QUT-Motorsport/QUTMS_TSAL/hardware/TSAL LED/Project Outputs for LED STRING/LED STRING.xlsx

Comment | Description | Designator | Footprint | LibRef | Quantity
XPERED-L1-R250-00401 | LED, Cree XLamp XP-E2 Series, Red, 630 nm, 130 °, 62 lm, 1 A | DS1, DS2, DS3, DS4 | Cree XLamp XP-E2 (red and green LED) | XPEBRD-L1-0000-00601 | 4
XPEGRN-L1-0000-00B01 | LED, Cree XLamp XP-E2 Series, Green, 535 nm, 135 °, 87.4 lm, 1 A | DS5, DS6, DS7 | Cree XLamp XP-E2 (red and green LED) | XPEBGR-L1-0000-00A01 | 3
Header 4 | Header, 4-Pin | P1, P2 | HDR1X4 | Header 4 | 2
