QUT-Motorsport/QUTMS_TSAL/hardware/TSAL LED/Project Outputs for TSAL2/TSAL2.xlsx

Comment | Description | Designator | Footprint | LibRef | Quantity
10uF 50V 5% X7R 0603 | Capacitor, Ceramic, SMD, 10uF, 50V, 5%, X7R, 0603 | C2_GREEN LED DRIVER, C2_RED LED DRIVER | Cap_Ceramic_0603(10uf) | 10uF 50V 5% X7R 0603 | 2
CMD21L8 TRPBFREE |  | D1_Voltage Reducer1, D1_Voltage Reducer2 | SODFL160X80-2N(Zener) | CMD21L8 TRPBFREE | 2
PMEG2005EJ | Diode, Schottky, SMD, 20 V, 500 mA, Single, SOD-323F, 2 Pins, 390 mV | D2_GREEN LED DRIVER, D2_RED LED DRIVER | SOD-323F(shottkey) | PMEG2005EJ | 2
SRN6045-101M | Inductor, 100 µH, 700 mA, Semishielded, 800 mA, SRN6045 Series, 6mm x 6mm x 4.5mm | L1_GREEN LED DRIVER, L1_RED LED DRIVER | Bourns Inductor 6x6x4.5mm(100mH) | SRN6045-101M | 2
LBL Hot Surface S | LBL Hot Surface S | LOGO1, LOGO3 | LBL HOT SMALL | LBL Hot Surface S | 2
2 Layer Identification PCB Marker | 2 Layer Identification PCB Marker | LYID1 | LAYER IDENT 2 | Layer Identification 2 | 1
Header 4 | Header, 4-Pin | P? | HDR1X4 | Header 4 | 1
10k 5% 0603 | Resistor, SMD, 10k, 0.1W, 5%, 0603 | R1_Voltage Reducer1, R1_Voltage Reducer2, R3_GREEN LED DRIVER, R3_RED LED DRIVER | Res_ThinFilm_0603 (1,10k) | 10k 5% 0603 | 4
1 1% 0603 | Resistor, SMD, 1, 0.1W, 1%, 0603 | R2_GREEN LED DRIVER, R2_RED LED DRIVER | Res_ThinFilm_0603 (1,10k) | 1 1% 0603 | 2
AP8801 | the LED drver fotr the red and green LED's | U1_GREEN LED DRIVER, U1_RED LED DRIVER | SOP8/SO8(AP8801) | AP8801 | 2
