QUT-Motorsport/QUTMS_TSAL/hardware/TSAL Control/Project Outputs for QUTMS-TSAL-V00/QUTMS-TSAL-V00.xlsx

Comment | Description | Designator | Footprint | LibRef | Quantity
4u7 50V | Capacitor, Ceramic, SMD, 4u7, 50V, 5%, X7R, 0603 | C1 | Cap_Ceramic_0603 | 4u7 50V 5% X7R 0603 | 1
10nF 25V 5% X7R 0402 | 10000pF ±5% 25V Ceramic Capacitor X7R 0402 (1005 Metric) | C2 | Cap_Ceramic_1206 | 10nF 25V 5% X7R 0402 | 1
22uF 35V | 22µF ±20% 35V Ceramic Capacitor X5R 1206 (3216 Metric) | C3 | Cap_Ceramic_1206 | 22uF 35V 20% X5R 1206 | 1
100nF 50V | Capacitor, Ceramic, SMD, 100nF, 50V, 5%, X7R, 0603 | C4 | Cap_Ceramic_0603 | 100nF 50V 5% X7R 0603 | 1
MM3Z56VB | Zener Diode 56V 200mW ±2% Surface Mount SOD-323F | D1 | SOD-323F | MM3Z56VB | 1
Microfit 3.0 1x2 |  | J1 | Microfit_1X2_R_TH | Microfit_1x2 | 1
Microfit 3.0 2x3 |  | J2 | Microfit_2X3_R_TH | Microfit_2x3 | 1
20mm Wide QUTMS Logo | 20mm Wide QUTMS Logo | LOGO1 | QUTMS LOGO 20MM | QUTMS Logo 20mm | 1
2 Layer Identification PCB Marker | 2 Layer Identification PCB Marker | LYID1 | LAYER IDENT 2 | Layer Identification 2 | 1
Hole M3 Loose Unplated | M3.5 Hole, No Plating | M1 | M3.5 UNPLATED | Hole M3 Loose Unplated | 1
CPH3351 | P-Channel 60V 1.8A (Ta) 1W (Ta) Surface Mount 3-CPH | Q1, Q2, Q3 | SOT-23-3 | CPH3351 | 3
1k | Resistor, SMD, 1k, 0.1W, 5%, 0603 | R1 | Res_ThinFilm_0603 | 1k 5% 0603 | 1
51k | 51 kOhms ±0.1% 0.063W, 1/16W Chip Resistor 0402 (1005 Metric) Automotive AEC-Q200 Thin Film | R2 | Res_ThinFilm_0603 | 51k 5% 0603 | 1
220R 5% 1206 | 220 Ohms ±1% 0.25W, 1/4W Chip Resistor 1206 (3216 Metric) Moisture Resistant Thick Film | R3 | Res_ThinFilm_1206 | 220R 5% 1206 | 1
1k 5% 0603 | Resistor, SMD, 1k, 0.1W, 5%, 0603 | R4 | Res_ThinFilm_0603 | 1k 5% 0603 | 1
LM555CMX | 555 Type, Timer/Oscillator (Single) IC 100kHz 8-SOIC | U1 | MCP2561 SOIC | LM555CMX | 1
CD4049UB | CD4049UB | U2 | CD4049UB | CD4049UB | 1
FOD817ASD | Optoisolator 5kV Transistor 4SMD | U3 | FOD817ASD | FOD817ASD | 1
