QUT-Motorsport/QUTMS_TSAL/hardware/TSAL LED/Project Outputs for QUTMS-TSAL/QUTMS-TSAL_LED.xlsx

Line # | Name | Description | Designator | Quantity | Manufacturer 1 | Manufacturer Part Number 1 | Manufacturer Lifecycle 1 | Supplier 1 | Supplier Part Number 1 | Supplier Unit Price 1 | Supplier Subtotal 1
 | 10uF X7R | Capacitor, Ceramic, SMD, 10uF, 50V, 5%, X7R, 0603 | C1A, C1B | 2
 | PMEG2005EJ | Diode, Schottky, SMD, 20 V, 500 mA, Single, SOD-323F, 2 Pins, 390 mV | D1A, D1B | 2
 | MMSZ5226BT1G | Diode, Zener, SMD, 3.3 V, 500 mW, SOD-123, 5 %, 2 Pins, 150 °C | D2A, D2B | 2
 | XPEBRD-L1-0000-00601 | LED, Cree XLamp XP-E2 Series, Red, 630 nm, 130 °, 62 lm, 1 A | DS1, DS2, DS3, DS4 | 4
 | XPEBGR-L1-0000-00A01 | LED, Cree XLamp XP-E2 Series, Green, 535 nm, 135 °, 87.4 lm, 1 A | DS5, DS6, DS7 | 3
 | SRN6045-101M | Inductor, 100 µH, 700 mA, Semishielded, 800 mA, SRN6045 Series, 6mm x 6mm x 4.5mm | L1A, L1B | 2
 | LBL Hot Surface S | LBL Hot Surface S | LOGO1, LOGO3 | 2
 | 2 Layer Identification PCB Marker | 2 Layer Identification PCB Marker | LYID1 | 1
 | Header 4 | Header, 4-Pin | P1, P2 | 2
 | 0R27 1% | Resistor, SMD, 0R27, 0.1W, 1%, 0603 | R1A, R1B | 2
 | 10k | Resistor, SMD, 10k, 0.1W, 5%, 0603 | R2A, R2B, R3A, R3B | 4
 | AL8860WT-7 | LED Driver, 1 Output, Buck (Step Down), 4.5 V to 40 V in, 1 MHz switch, PWM, 40V/1 A out, TSOT-25-5 | U1A, U1B | 2
