QUT-Motorsport/QUTMS_TSAL/(threads)

Thread 2 (2020-07-15):

QEV3 TSAL Redesign

LDwhoRU, 2020-07-15:
- [ ] LED Board
- [ ] Control Board
- [ ] Case Design
