QUT-Motorsport/QUTMS_TSAL/hardware/TSAL Control/QUTMS-TSAL-V00.pdf

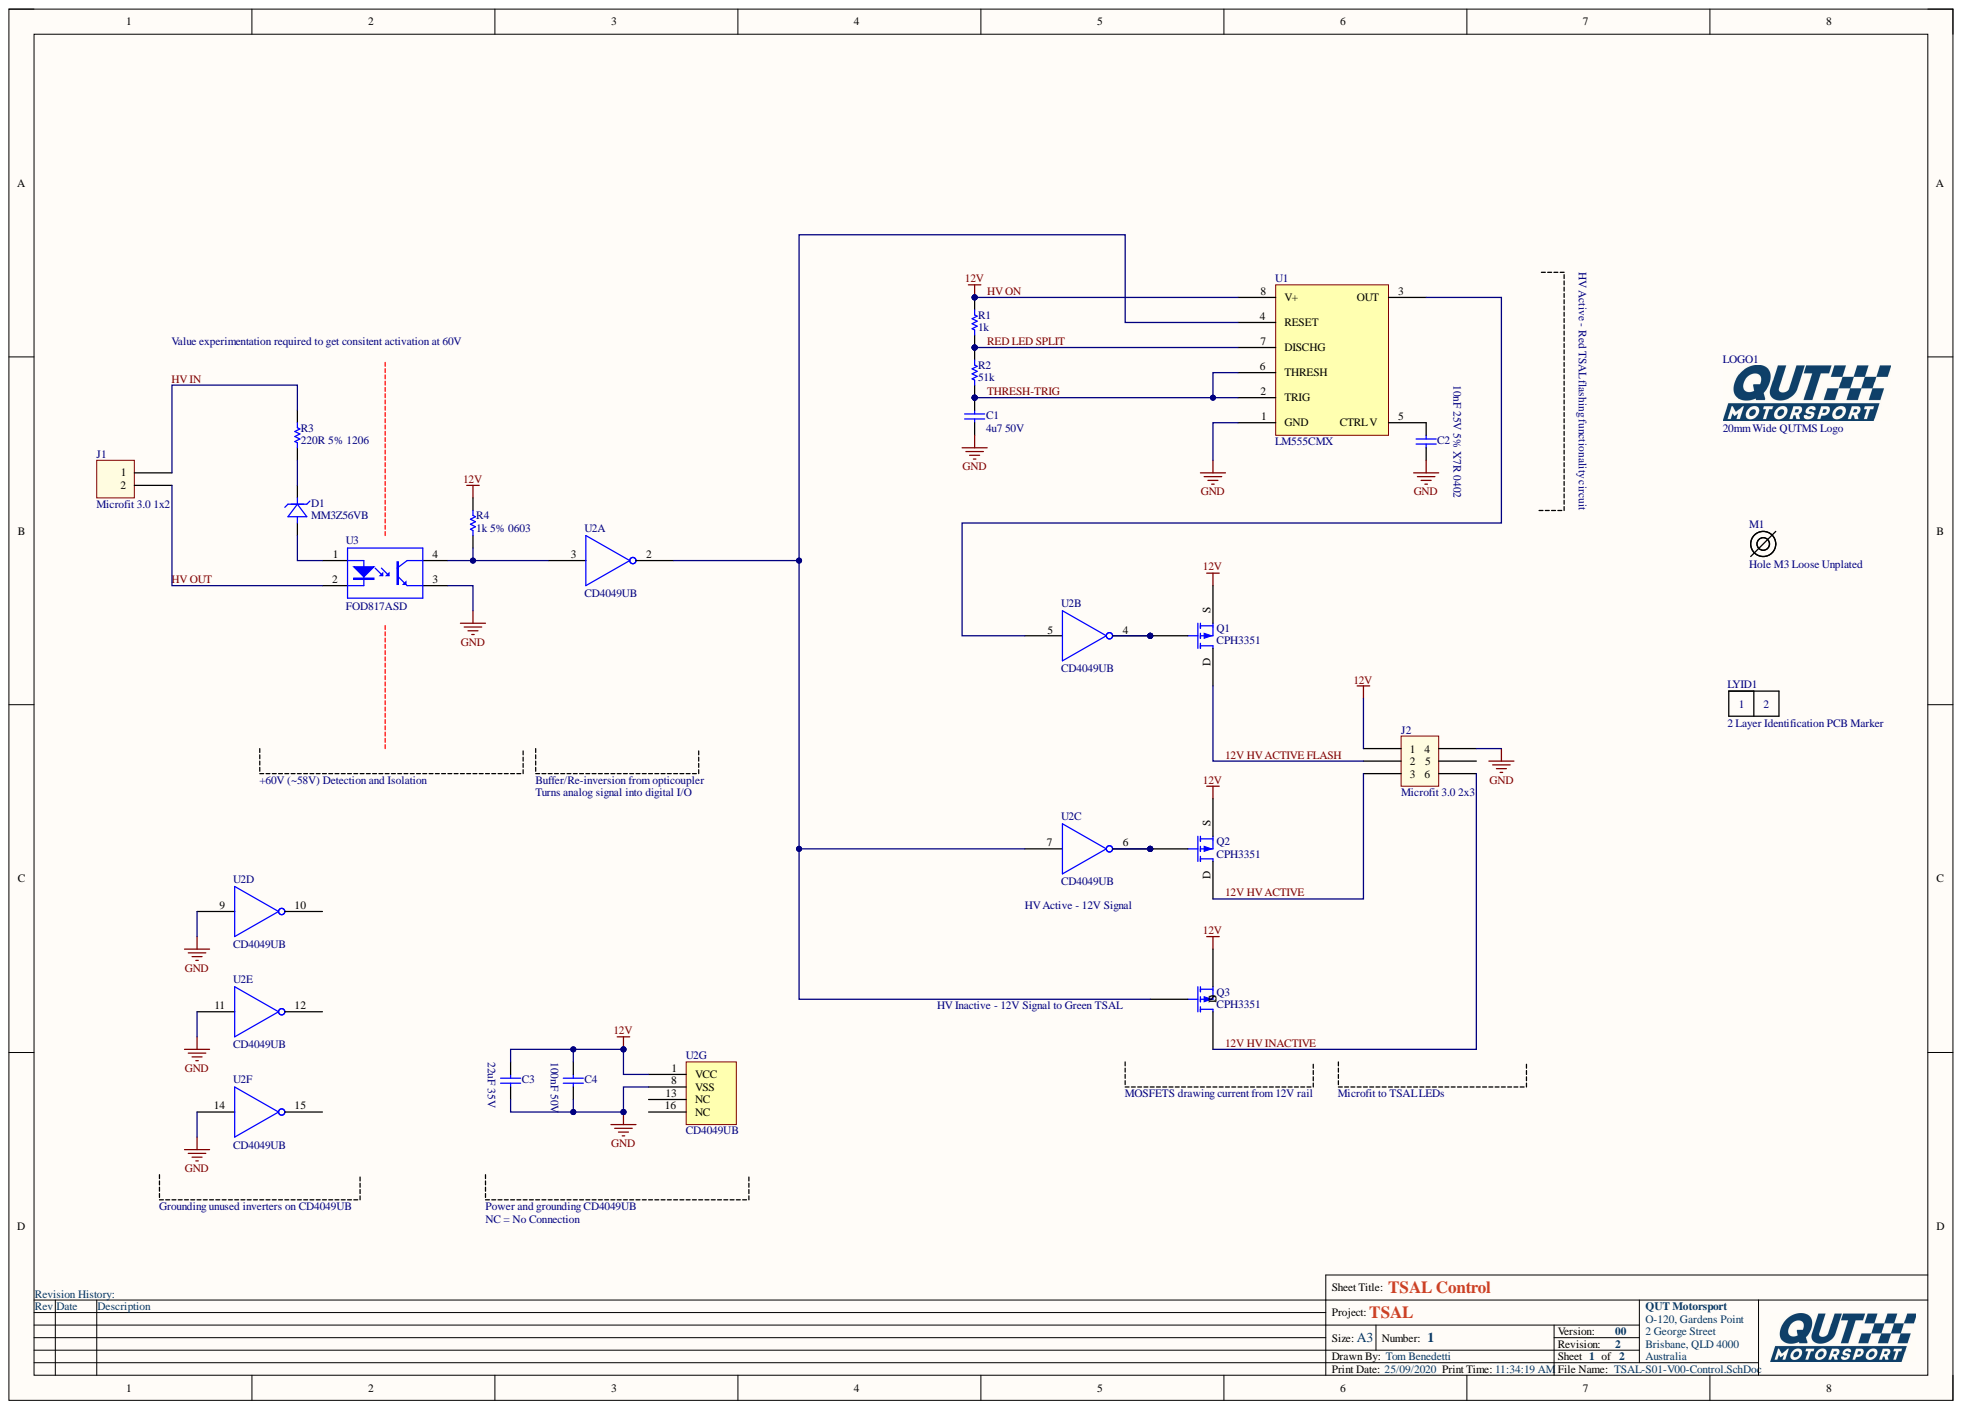
[picture p1: page 1]

HV Active - Red TSALflashing functionality circuit

red to get con

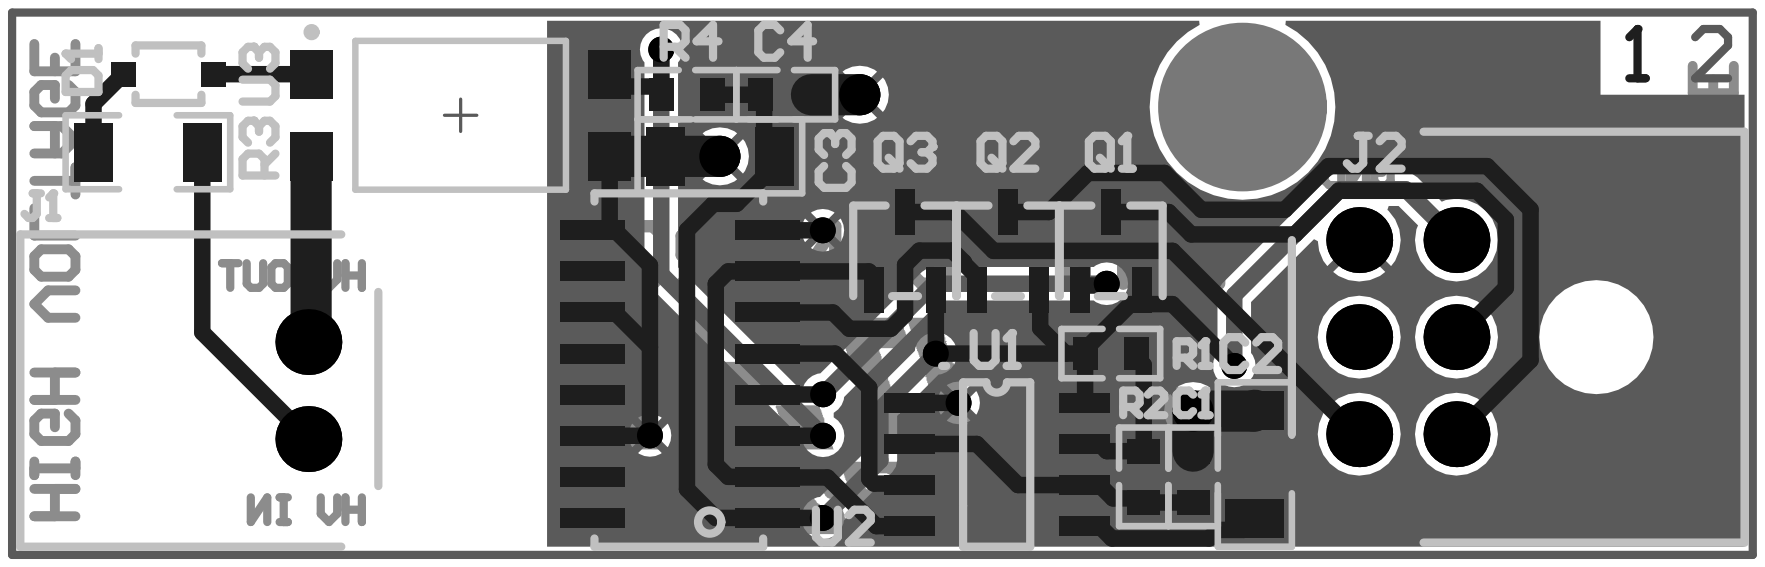
[picture p2: page 2]
