QUT-Motorsport/QUTMS_TSAL/hardware/TSAL LED/QUTMS-TSAL.pdf

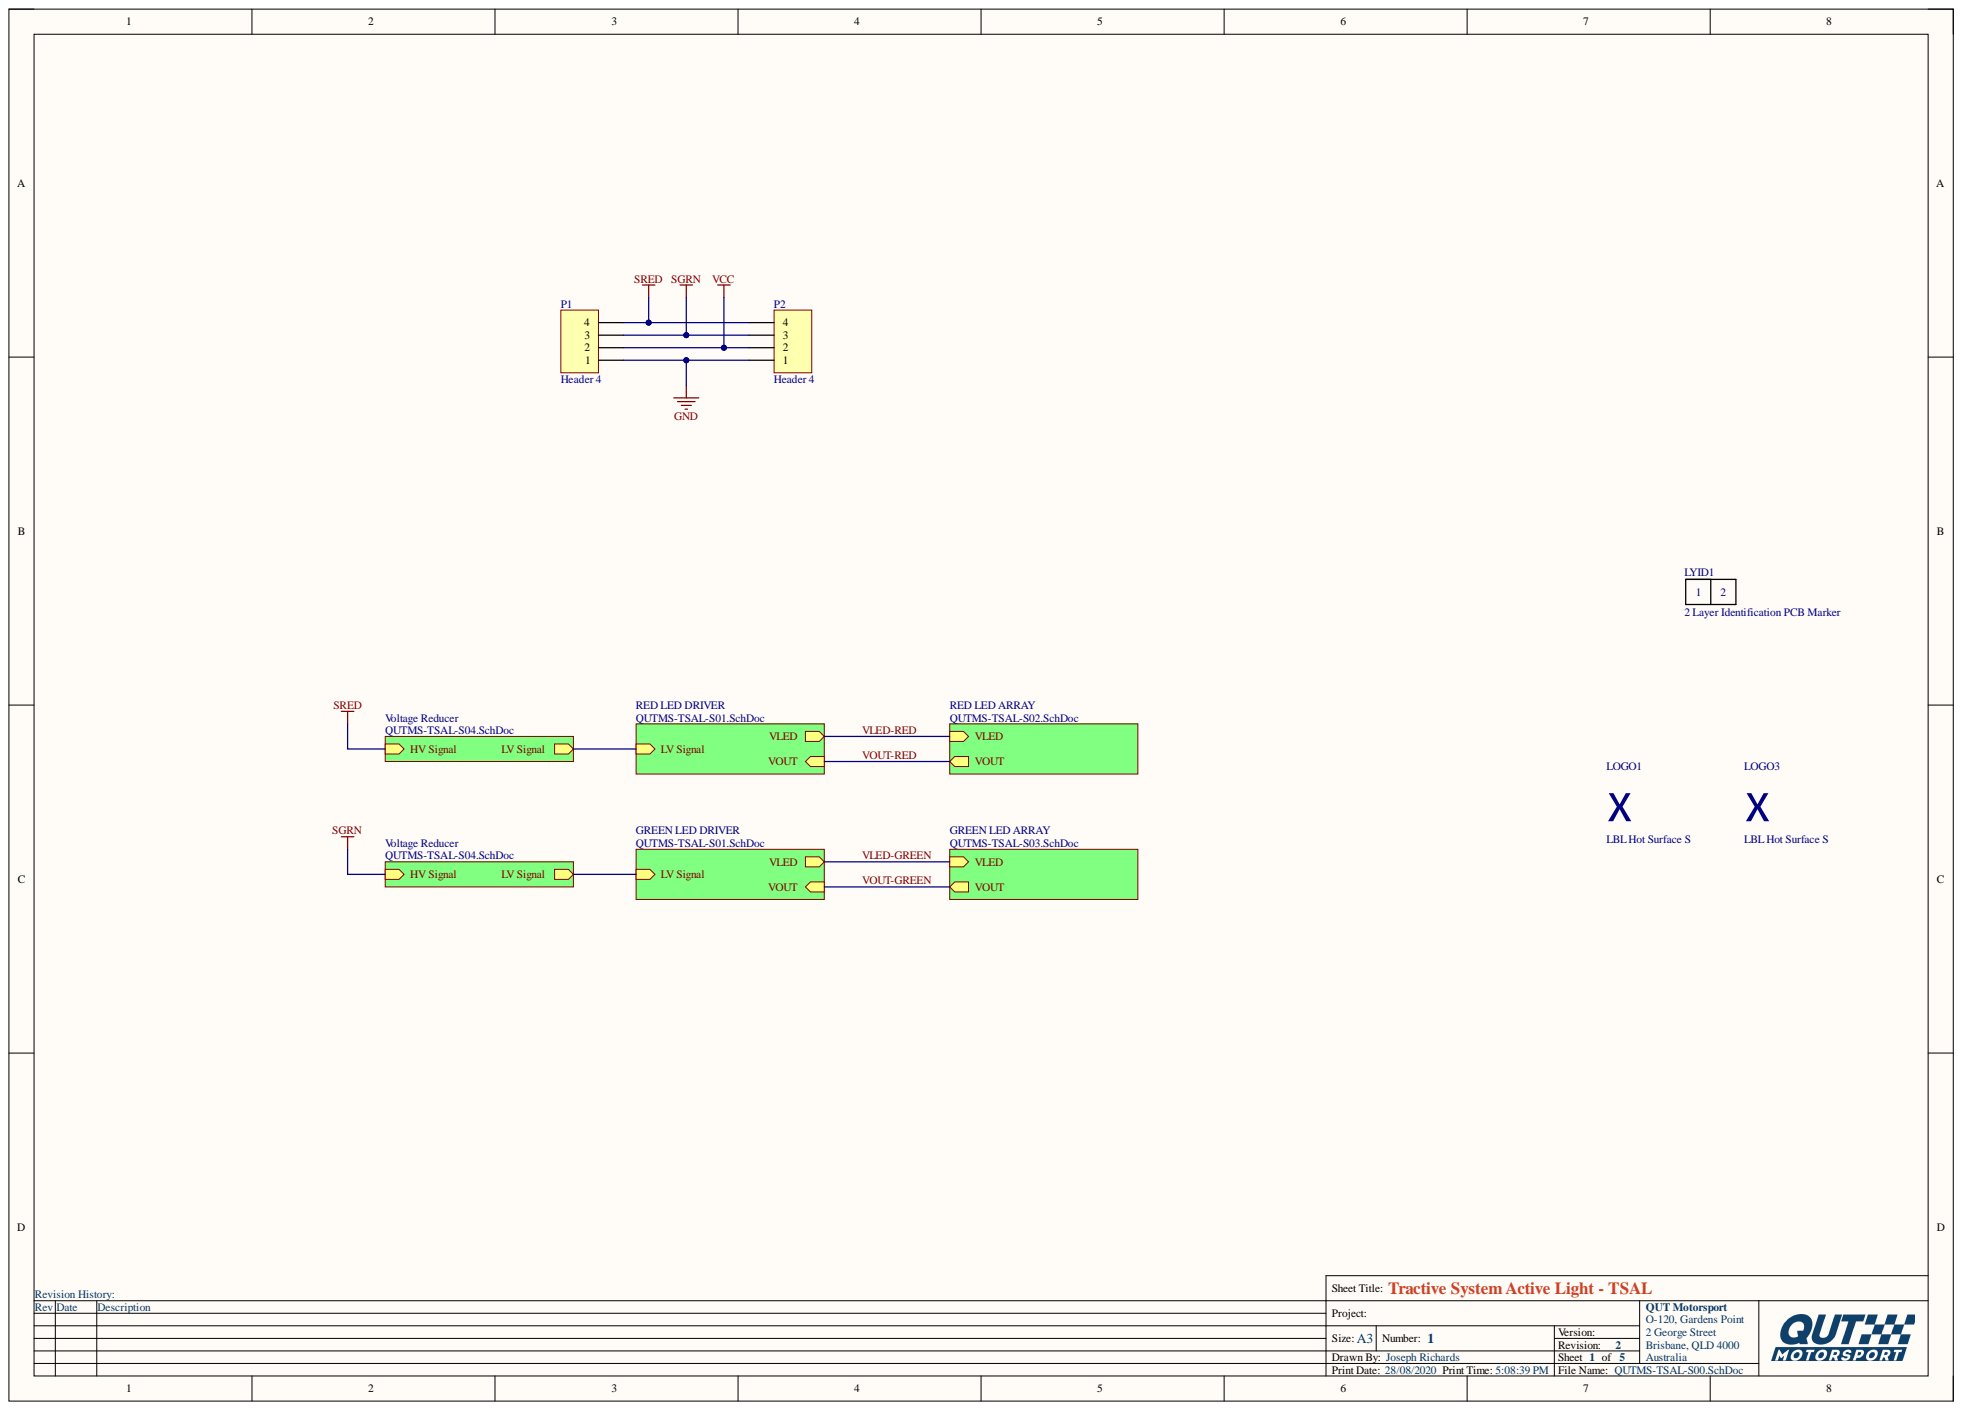
[picture p3: page 1]

LYID1
2 Layer Identification PCB Marker

Sheet Title: Tractive System Active Light - TSAL

Drawn By: Joseph Richards

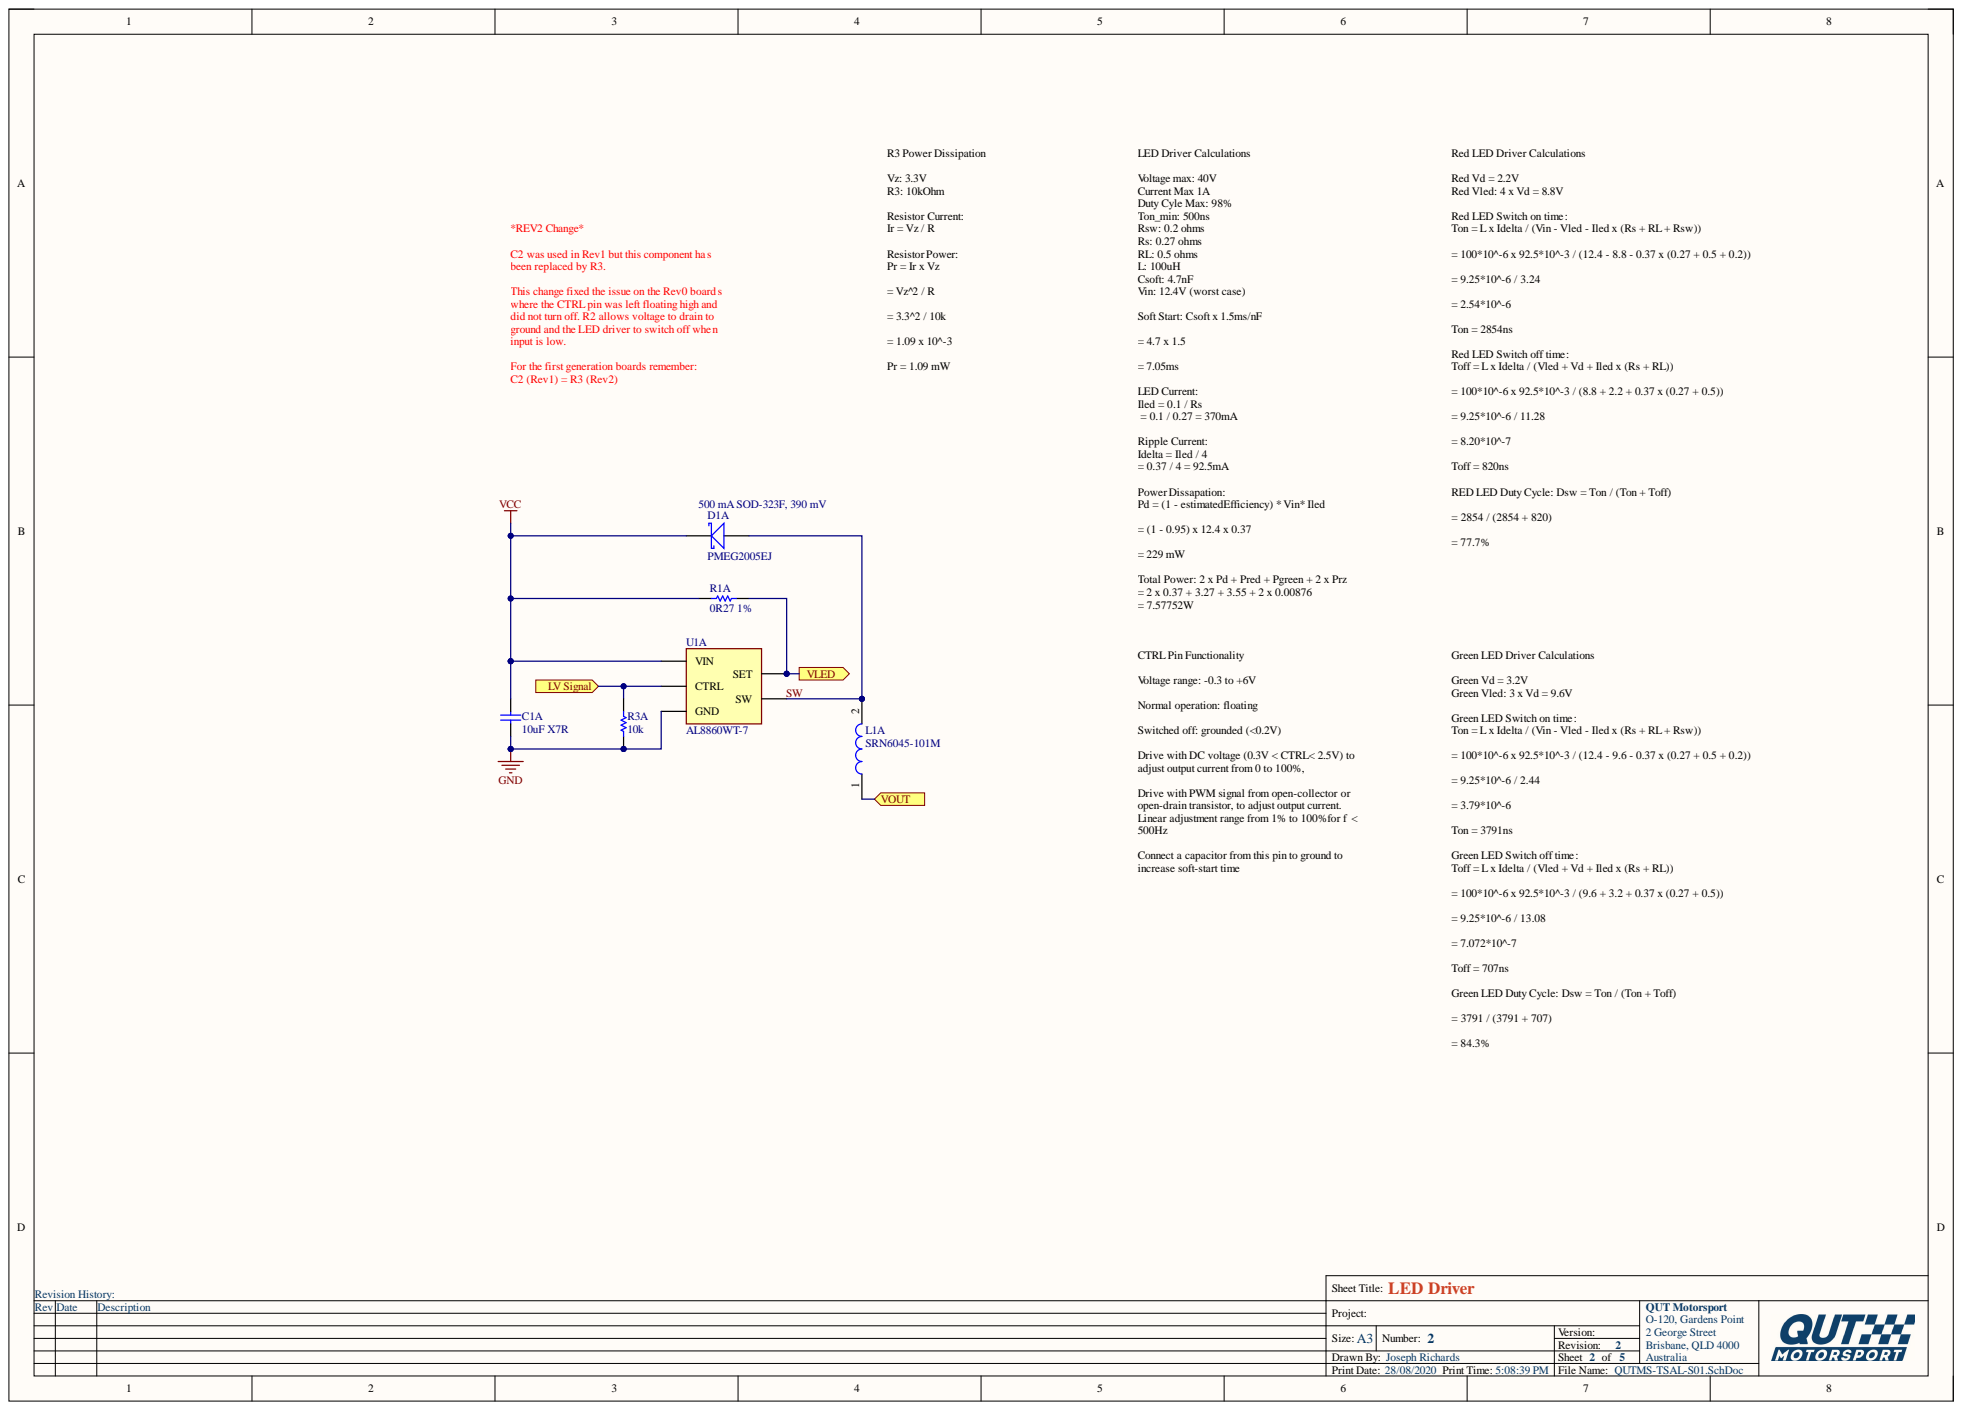
[picture p4: page 2]

Red LED Driver Calculations

Red LED Switch on time:
Ton = L x Idelta / (Vin - Vled - Iled x (Rs + RL + Rsw))

C2 was used in Rev1 but this component has
been replaced by R3.

This change fixed the issue on the Rev0 boards
where the CTRL pin was left floating high and
did not turn off. R2 allows voltage to drain to
ground and the LED driver to switch off when
input is low.

Soft Start: Csoft x 1.5ms/nF

Red LED Switch off time:
Toff = L x Idelta / (Vled + Vd + Iled x (Rs + RL))

For the first generation boards remember:
C2 (Rev1) = R3 (Rev2)

Power Dissapation:
Pd = (1 - estimatedEfficiency) * Vin* Iled

RED LED Duty Cycle: Dsw = Ton / (Ton + Toff)

Total Power: 2 x Pd + Pred + Pgreen + 2 x Prz

Green LED Driver Calculations

Green LED Switch on time:

Drive with DC voltage (0.3V < CTRL< 2.5V) to
adjust output current from 0 to 100%,

Drive with PWM signal from open-collector or
open-drain transistor, to adjust output current.
Linear adjustment range from 1% to 100%for f <

Connect a capacitor from this pin to ground to
increase soft-start time

Green LED Switch off time:

Green LED Duty Cycle: Dsw = Ton / (Ton + Toff)

Sheet Title: LED Driver

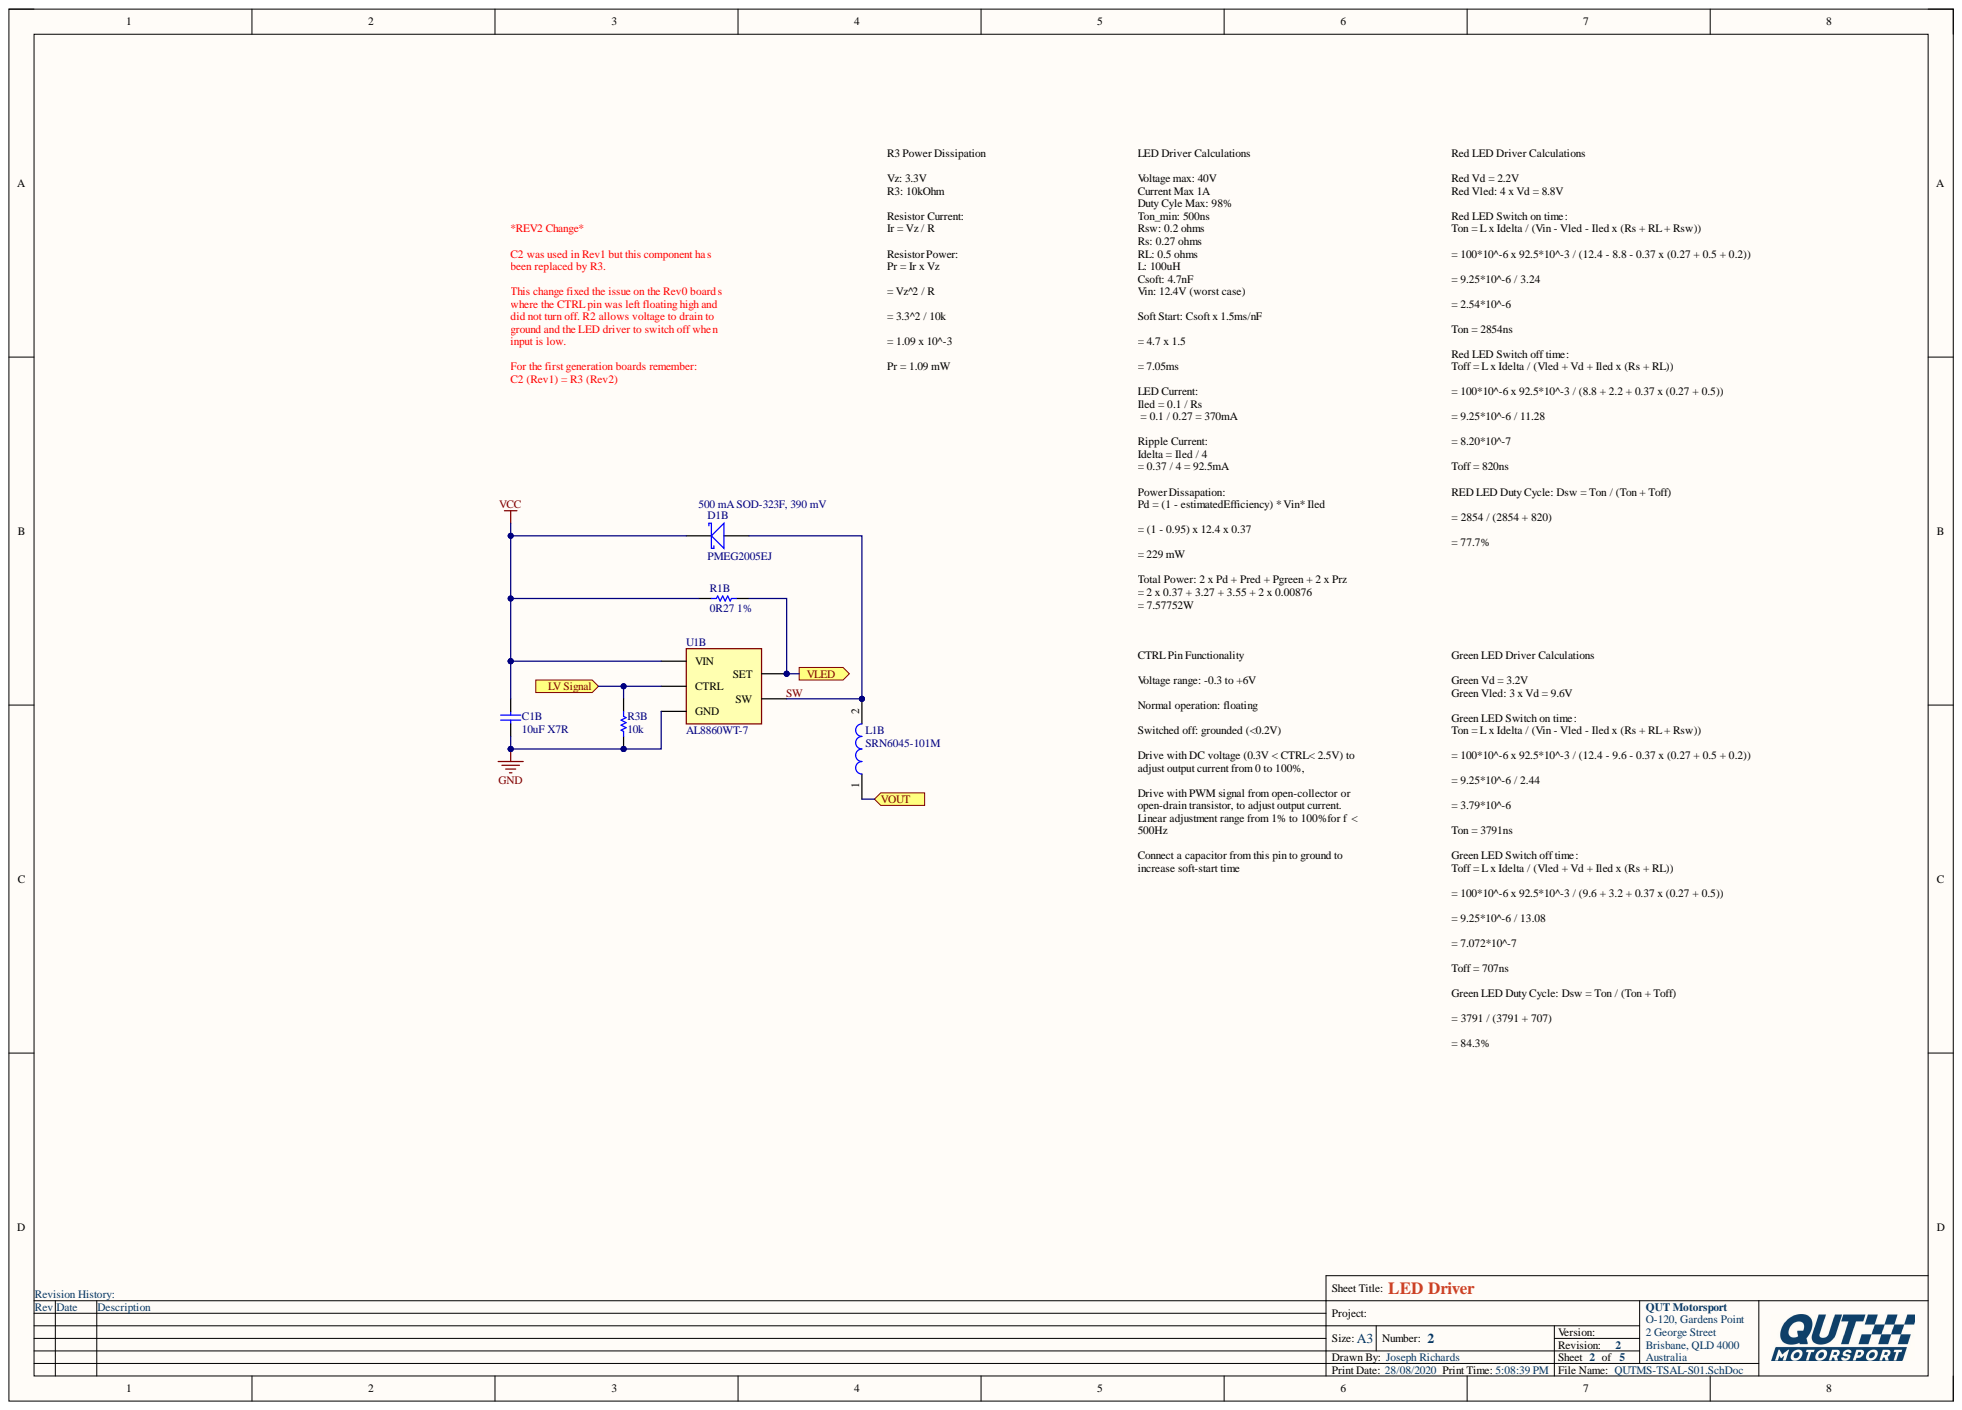
[picture p5: page 3]

Red LED Driver Calculations

Red LED Switch on time:
Ton = L x Idelta / (Vin - Vled - Iled x (Rs + RL + Rsw))

C2 was used in Rev1 but this component has
been replaced by R3.

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

Soft Start: Csoft x 1.5ms/nF

Red LED Switch off time:
Toff = L x Idelta / (Vled + Vd + Iled x (Rs + RL))

For the first generation boards remember:
C2 (Rev1) = R3 (Rev2)

Power Dissapation:
Pd = (1 - estimatedEfficiency) * Vin* Iled

RED LED Duty Cycle: Dsw = Ton / (Ton + Toff)

Total Power: 2 x Pd + Pred + Pgreen + 2 x Prz

Green LED Driver Calculations

Green LED Switch on time:

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

Connect a capacitor from this pin to ground to
increase soft-start time

Green LED Switch off time:

Green LED Duty Cycle: Dsw = Ton / (Ton + Toff)

Sheet Title: LED Driver

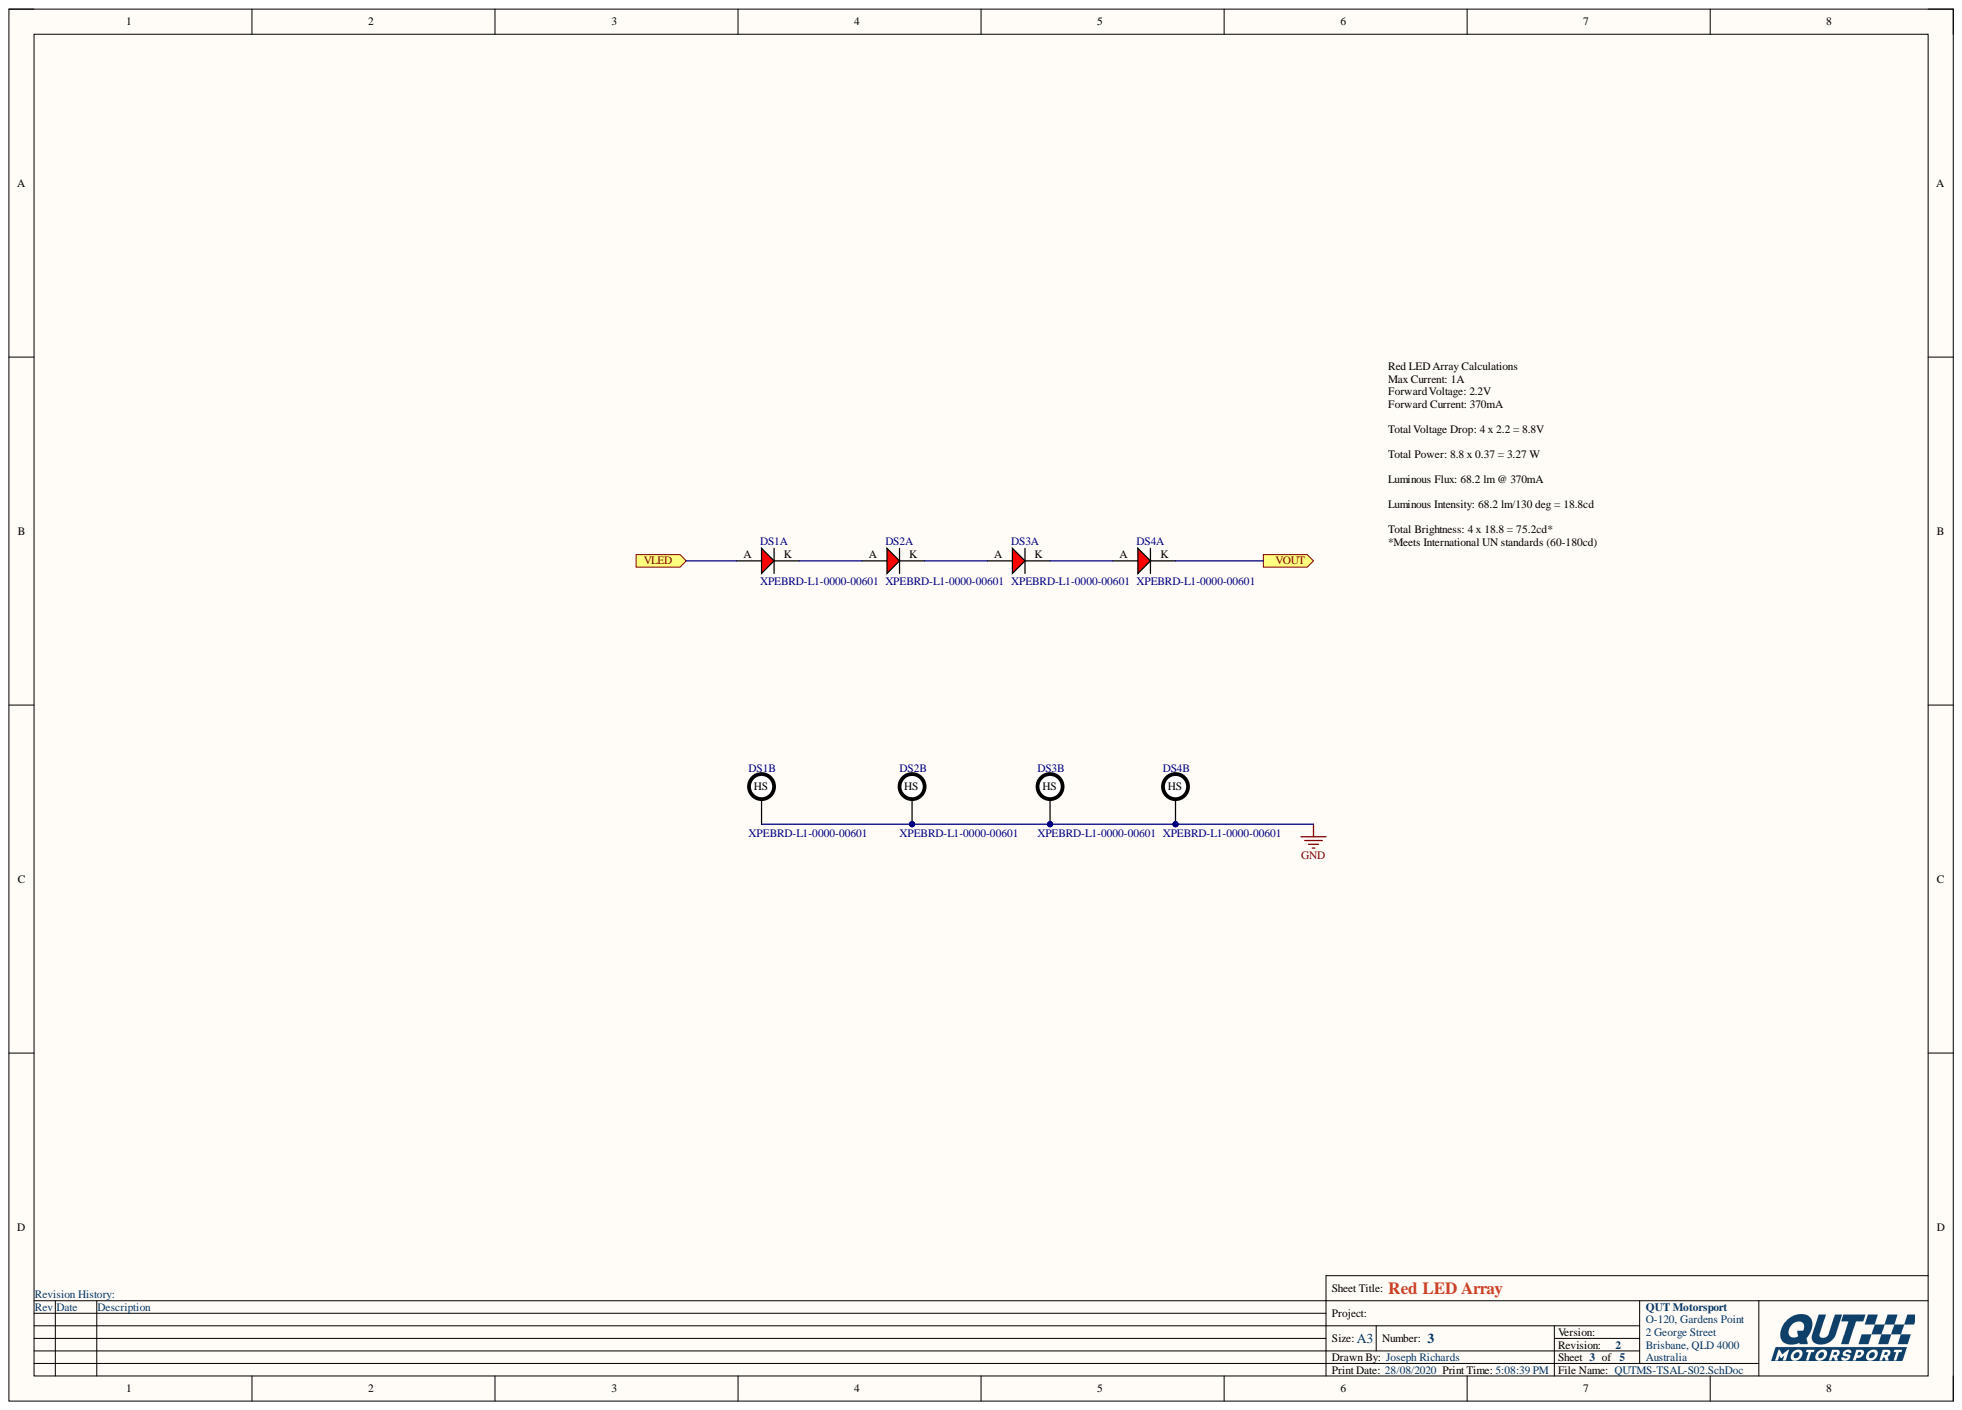
[picture p6: page 4]

Red LED Array Calculations
Max Current: 1A
Forward Voltage: 2.2V
Forward Current: 370mA

Luminous Intensity: 68.2 lm/130 deg = 18.8cd

Total Brightness: 4 x 18.8 = 75.2cd*
*Meets International UN standards (60-180cd)

Sheet Title: Red LED Array

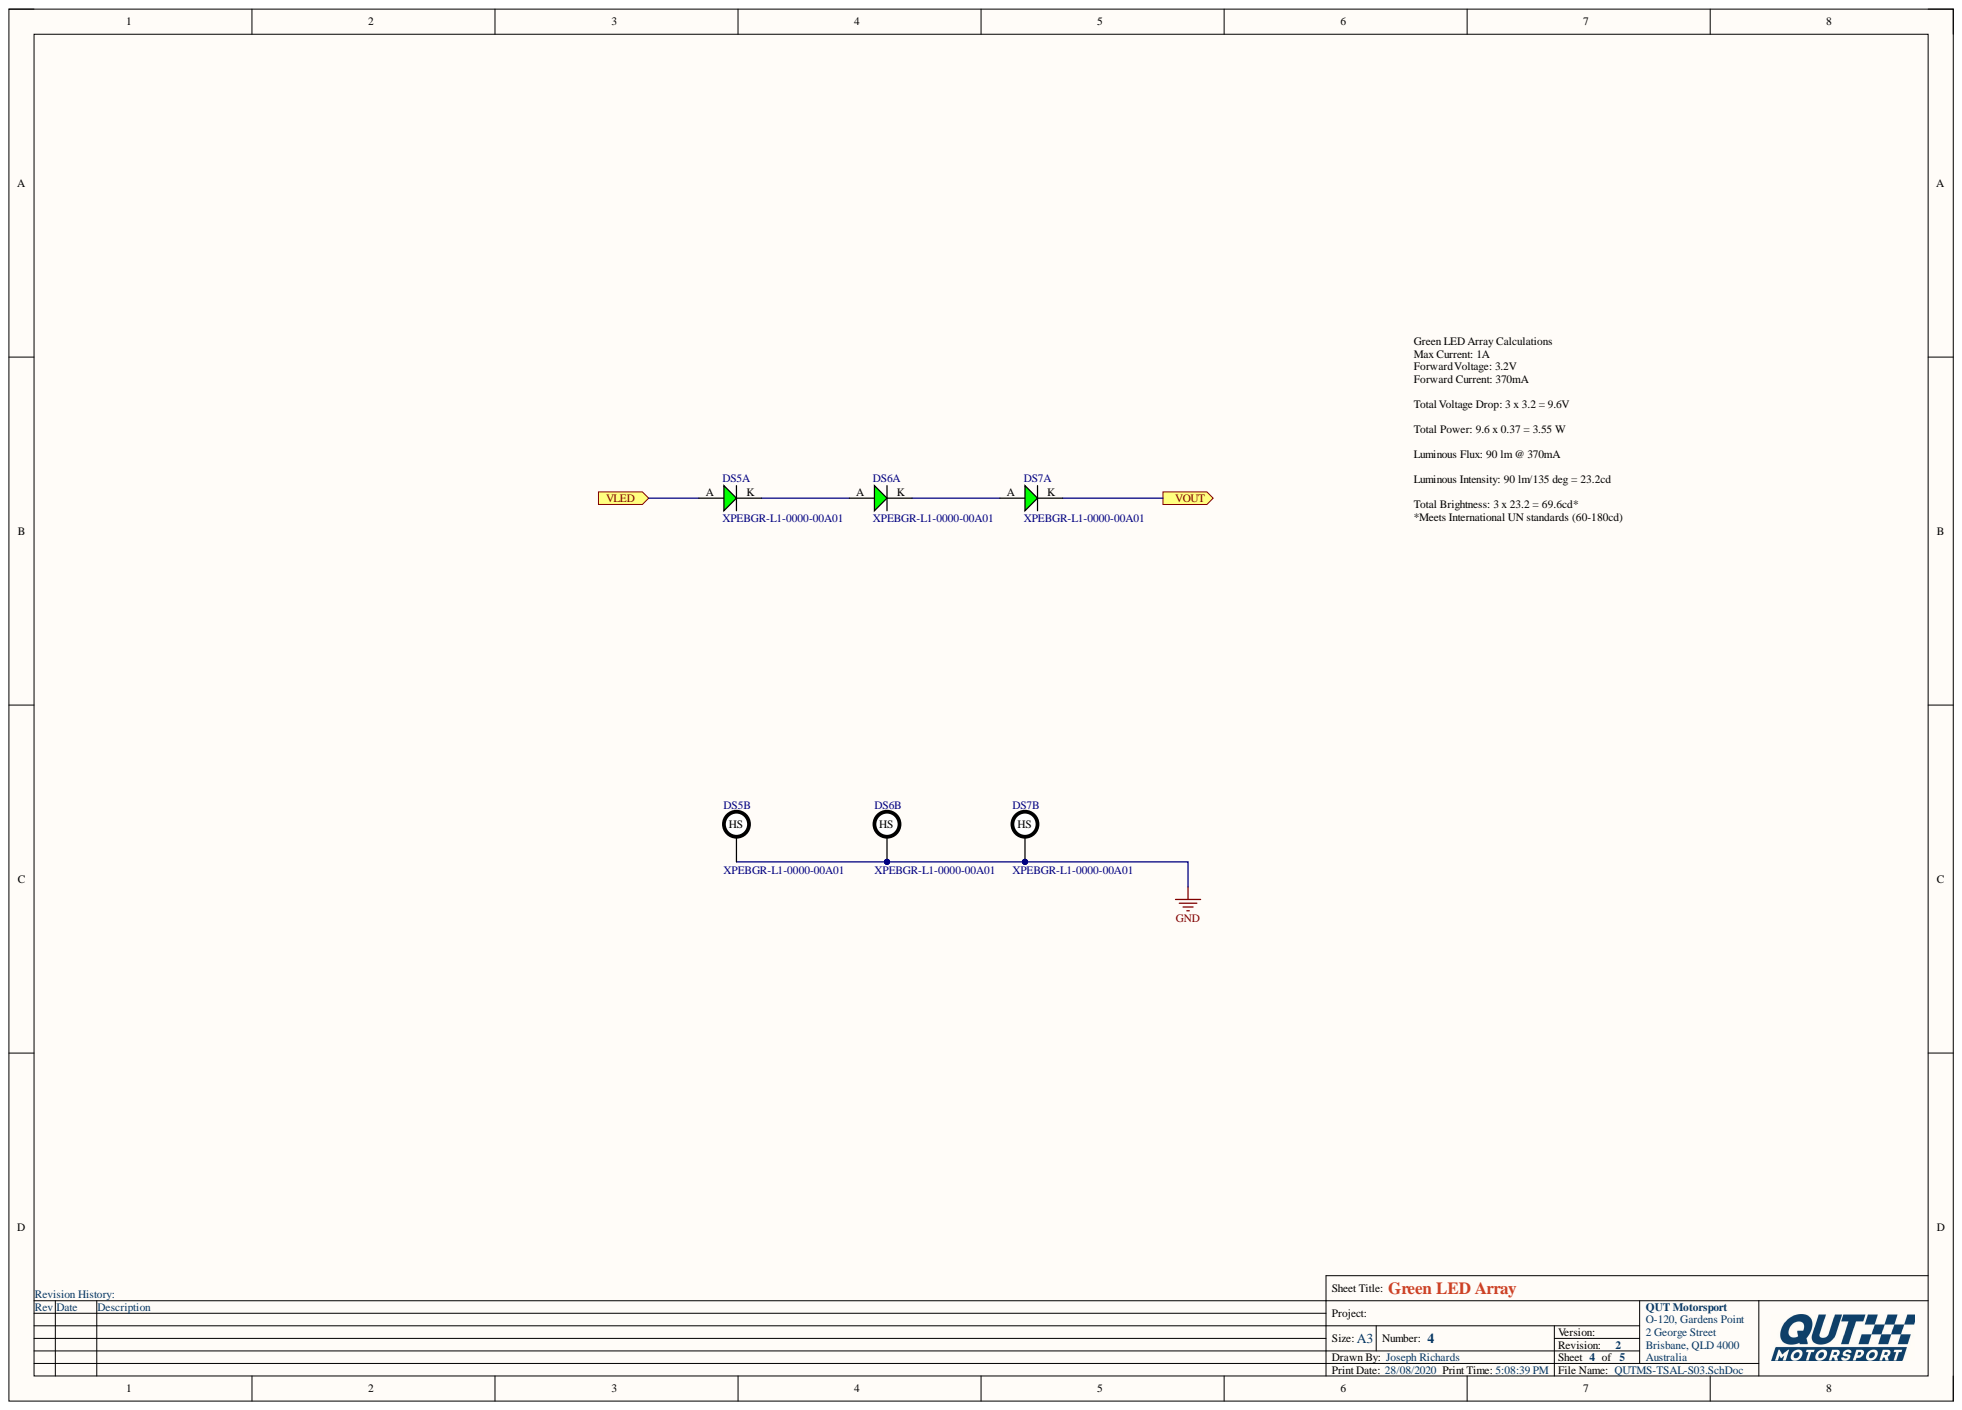
[picture p7: page 5]

Green LED Array Calculations
Max Current: 1A
Forward Voltage: 3.2V
Forward Current: 370mA

Luminous Intensity: 90 lm/135 deg = 23.2cd

Total Brightness: 3 x 23.2 = 69.6cd*
*Meets International UN standards (60-180cd)

Sheet Title: Green LED Array

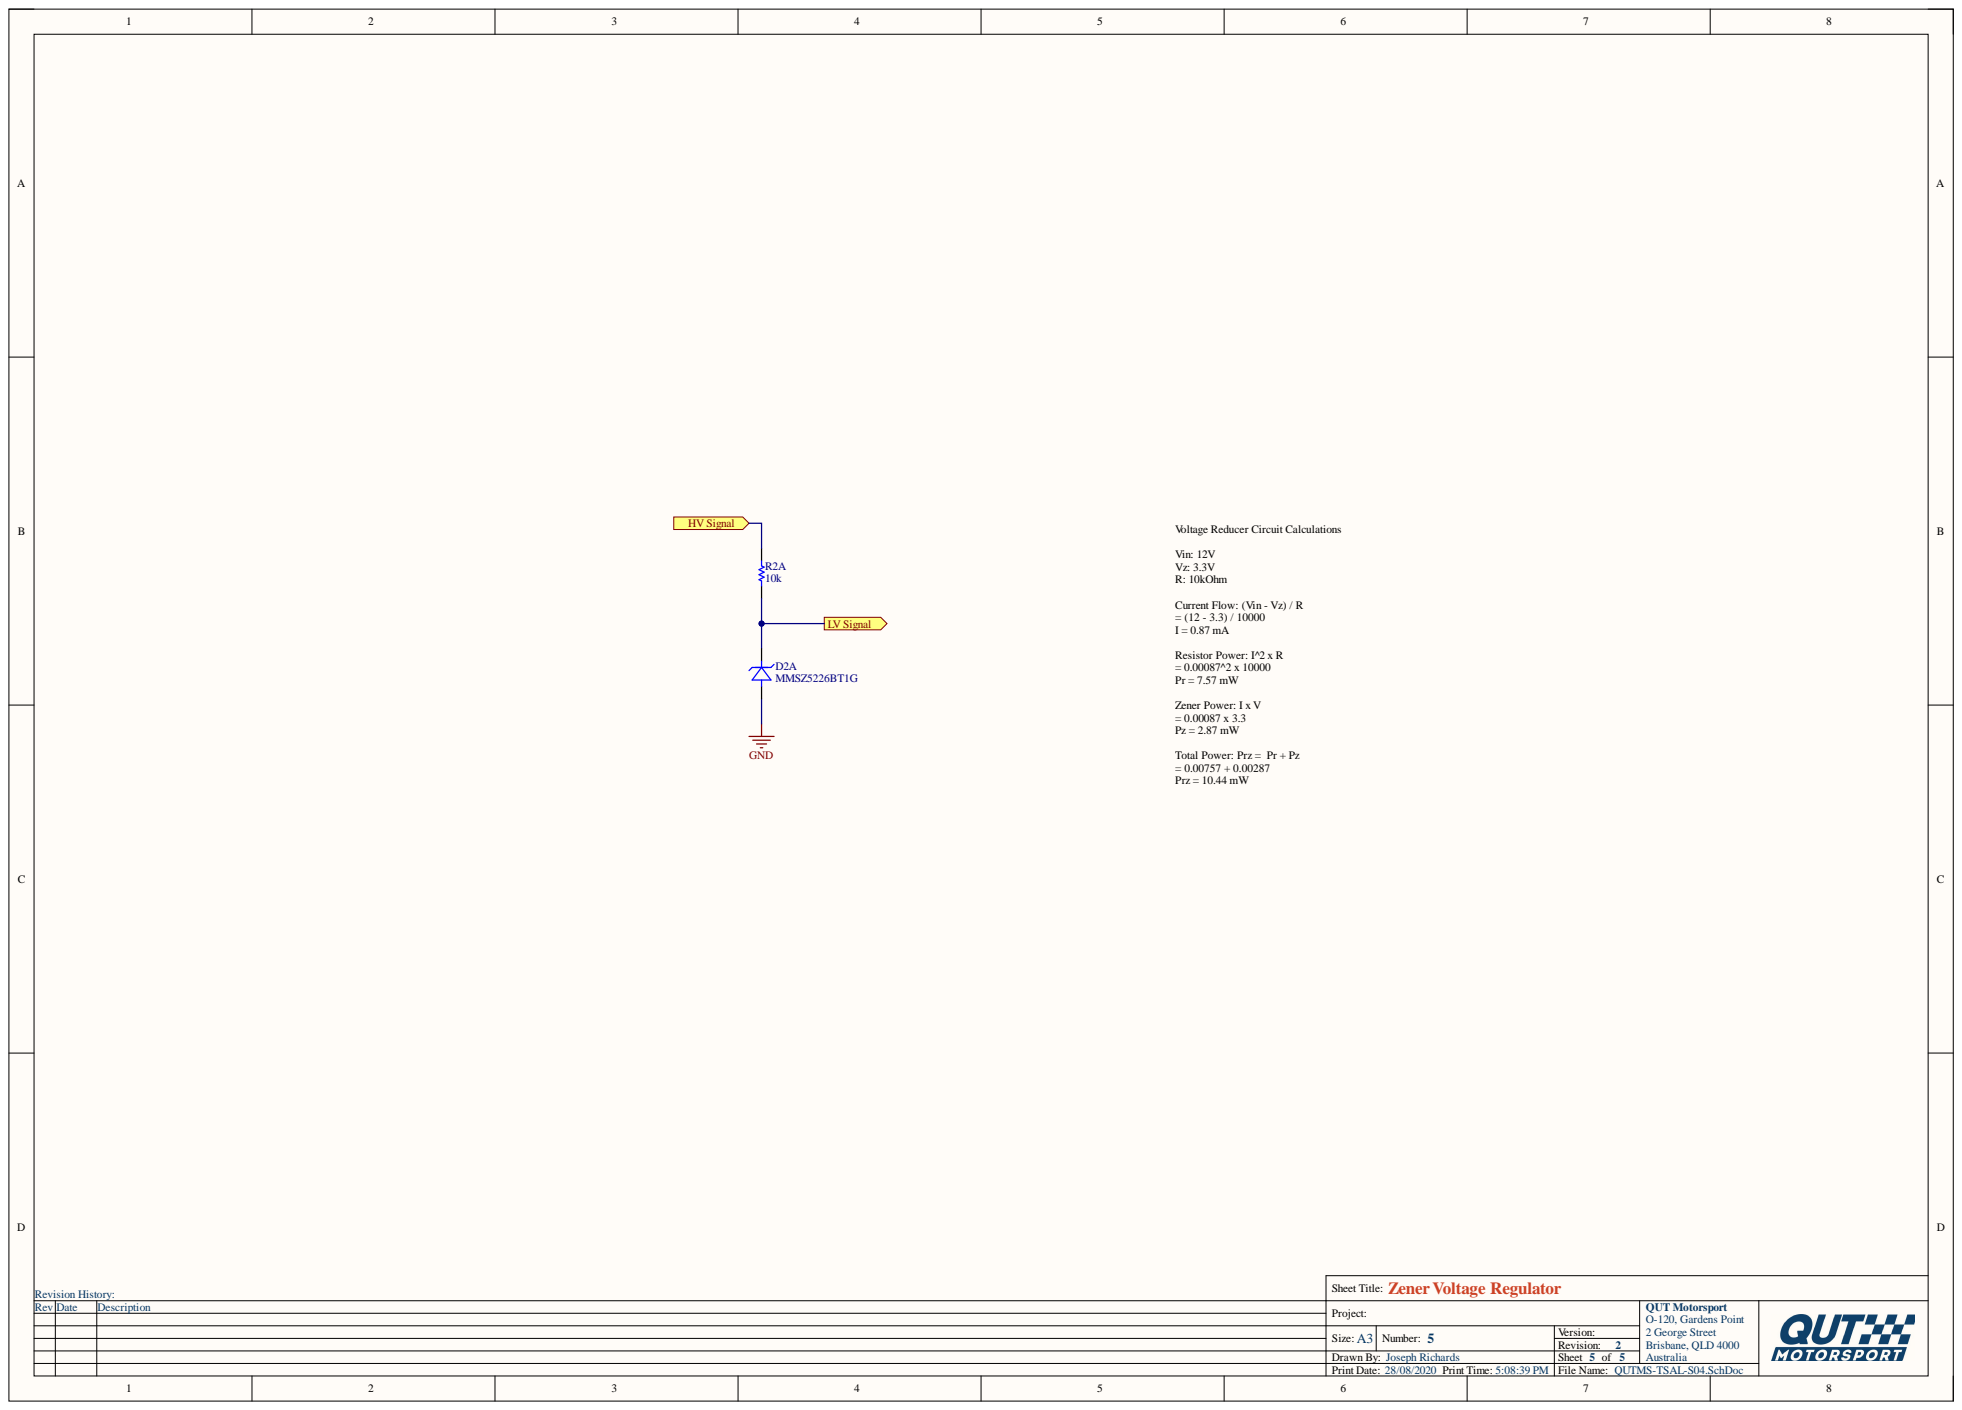
[picture p8: page 6]

Voltage Reducer Circuit Calculations

Total Power: Prz = Pr + Pz
Prz = 10.44 mW

Sheet Title: Zener Voltage Regulator

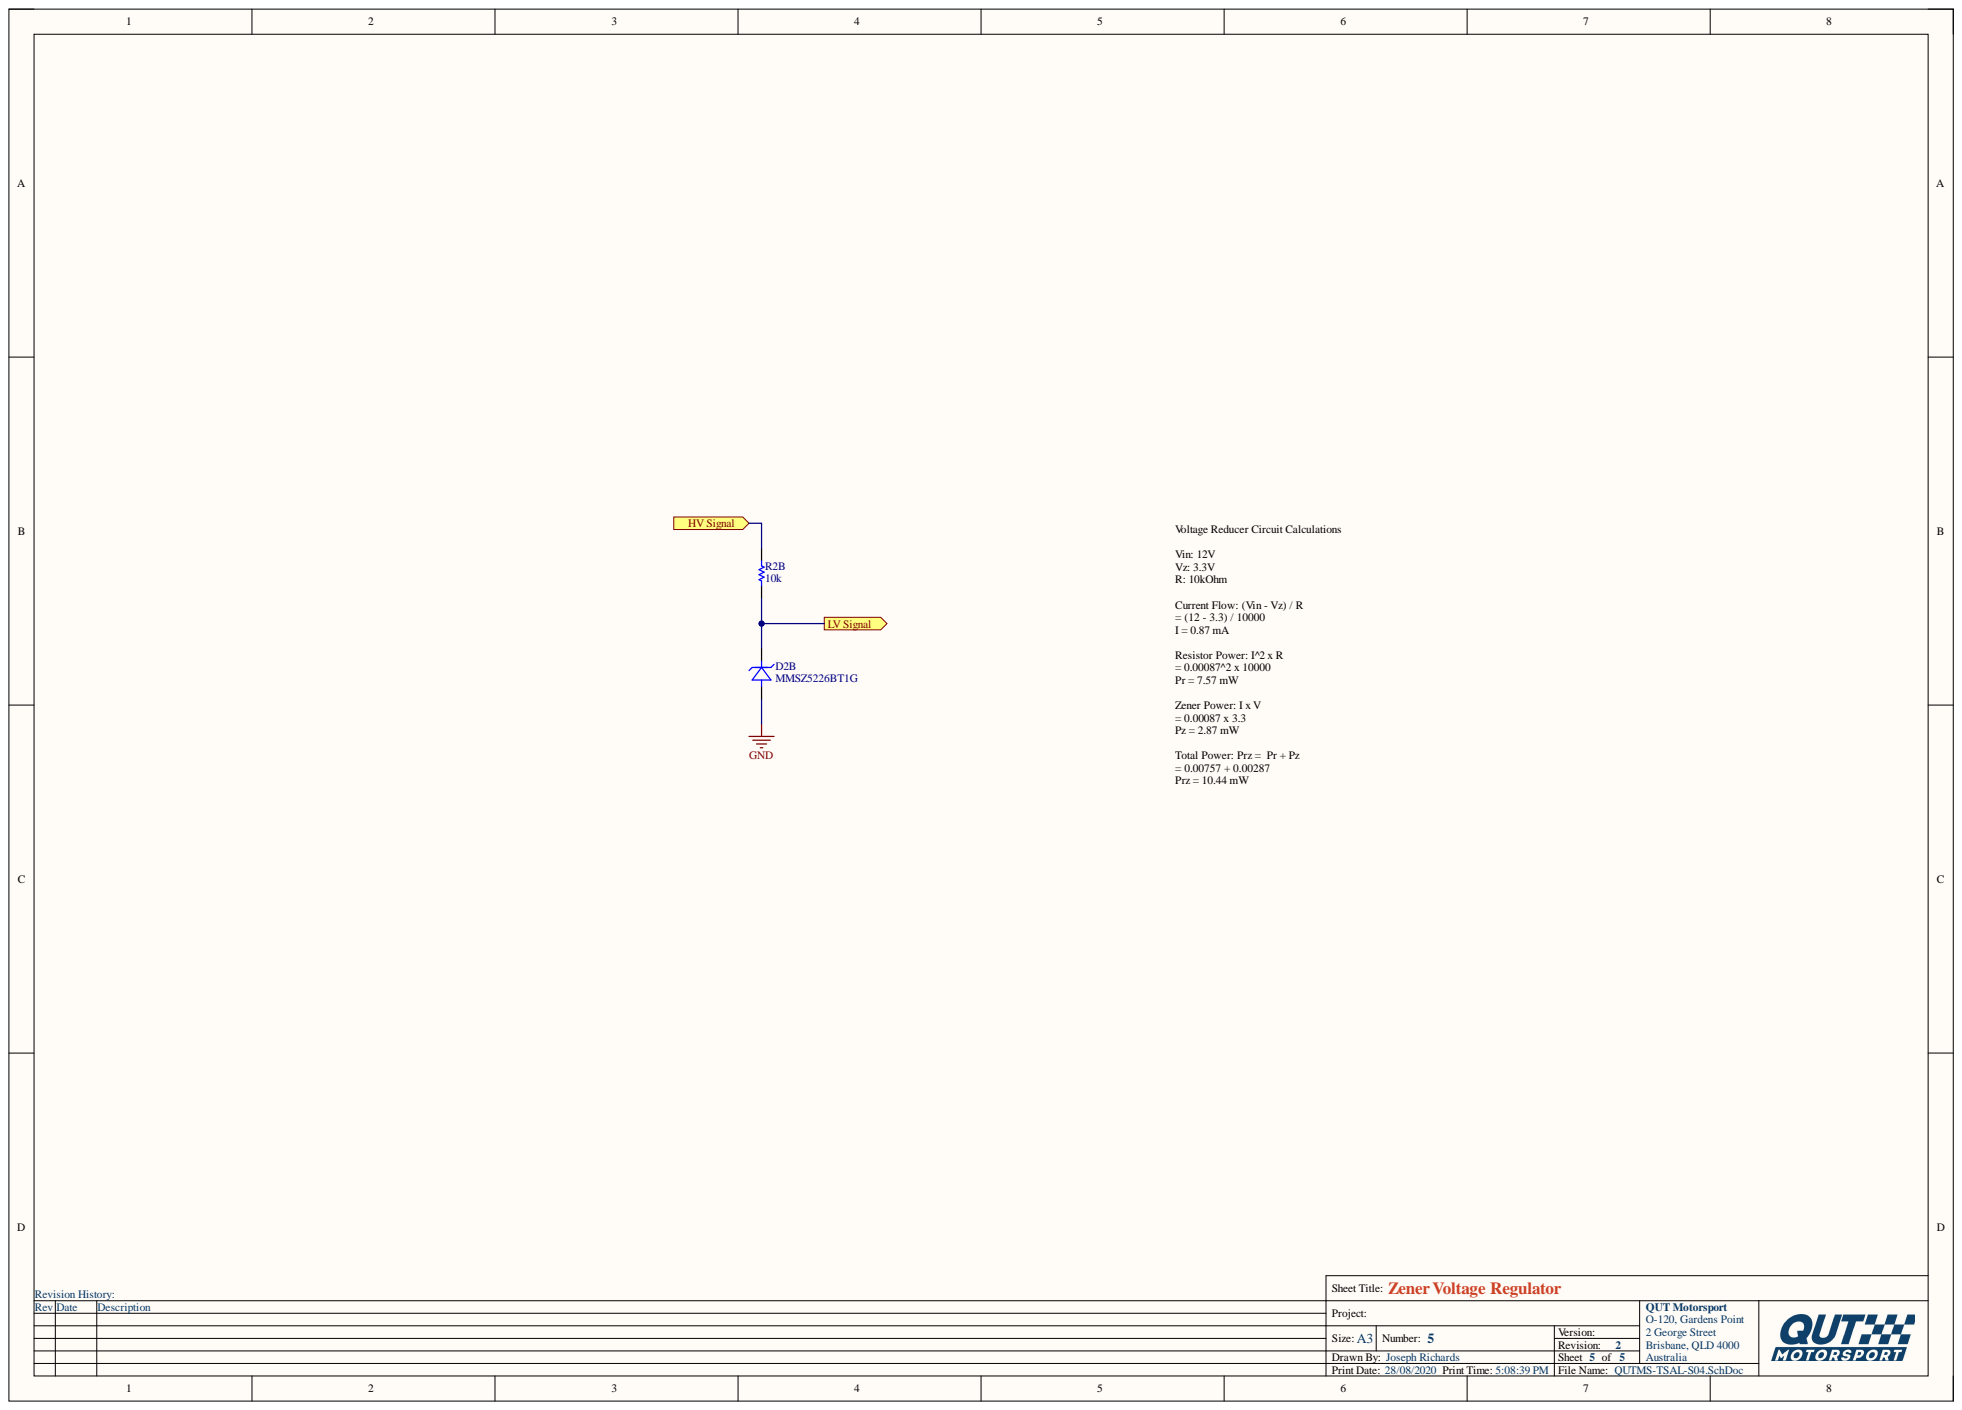
[picture p9: page 7]

Voltage Reducer Circuit Calculations

Total Power: Prz = Pr + Pz
Prz = 10.44 mW

Sheet Title: Zener Voltage Regulator

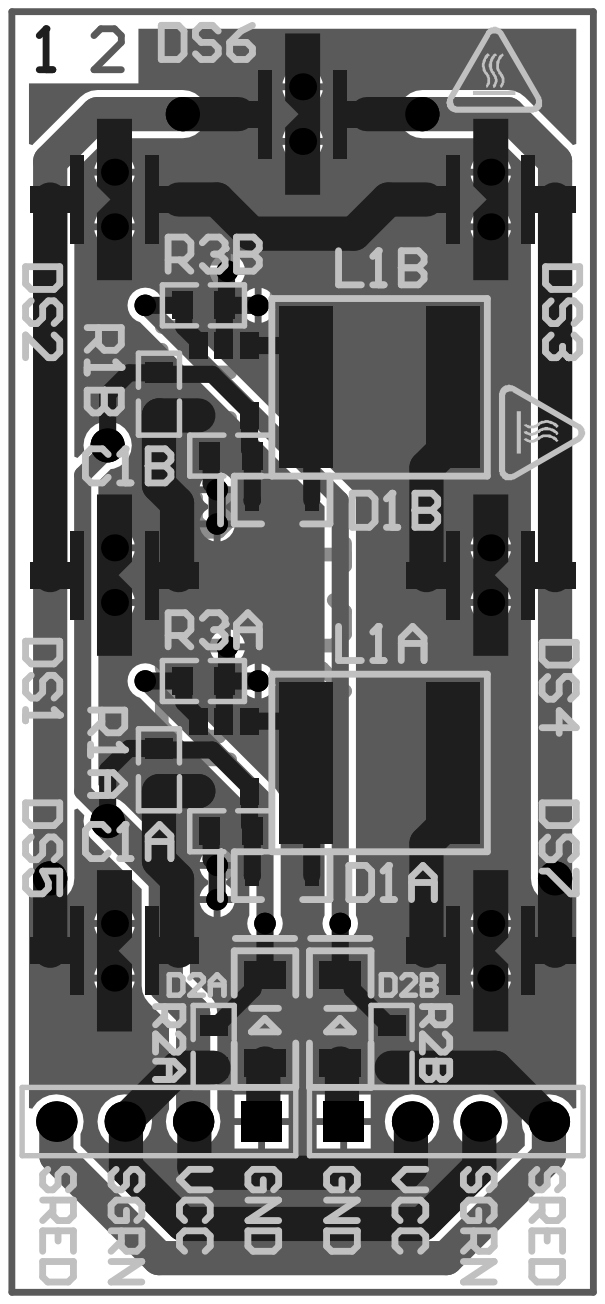
[picture p10: page 8]
