QUT-Motorsport/QUTMS_TSAL/(list of files, drawings)

Other design files:
hardware/TSAL Control/CellMonitor.PcbLib
hardware/TSAL Control/CellMonitor.SchLib
hardware/TSAL Control/IDCConnectors.PcbLib
hardware/TSAL Control/IDCConnectors.SchLib
hardware/TSAL Control/OpAmpAttempt.SchLib
hardware/TSAL Control/QUTMS-TSAL-V00.PrjPcb
hardware/TSAL Control/QUTMS_BuzzerLibrary.PcbLib
hardware/TSAL Control/QUTMS_BuzzerLibrary.SchLib
hardware/TSAL Control/QUTMS_CANLibrary.PcbLib
hardware/TSAL Control/QUTMS_CANLibrary.SchLib
hardware/TSAL Control/QUTMS_DiodeLibrary.PcbLib
hardware/TSAL Control/QUTMS_DiodeLibrary.SchLib
hardware/TSAL Control/QUTMS_InductorLibrary.PcbLib
hardware/TSAL Control/QUTMS_InductorLibrary.SchLib
hardware/TSAL Control/QUTMS_IntegratedCircuitLibrary.PcbLib
hardware/TSAL Control/QUTMS_IntegratedCircuitLibrary.SchLib
hardware/TSAL Control/QUTMS_JumperLibrary.PcbLib
hardware/TSAL Control/QUTMS_JumperLibrary.SchLib
hardware/TSAL Control/QUTMS_LEDLibrary.PcbLib
hardware/TSAL Control/QUTMS_LEDLibrary.SchLib
hardware/TSAL Control/QUTMS_LogicLibrary.PcbLib
hardware/TSAL Control/QUTMS_LogicLibrary.SchLib
hardware/TSAL Control/QUTMS_MicrofitLibrary.PcbLib
hardware/TSAL Control/QUTMS_MicrofitLibrary.SchLib
hardware/TSAL Control/QUTMS_OpAmpLibrary.PcbLib
hardware/TSAL Control/QUTMS_OpAmpLibrary.SchLib
hardware/TSAL Control/QUTMS_OpAmps.PcbLib
hardware/TSAL Control/QUTMS_OpAmps.SchLib
hardware/TSAL Control/QUTMS_PCBLibrary.PcbLib
hardware/TSAL Control/QUTMS_RelayLibrary.PcbLib
hardware/TSAL Control/QUTMS_RelayLibrary.SchLib
hardware/TSAL Control/QUTMS_SDLibrary.PcbLib
hardware/TSAL Control/QUTMS_SDLibrary.SchLib
hardware/TSAL Control/QUTMS_STM32Library.PcbLib
hardware/TSAL Control/QUTMS_STM32Library.SchLib
hardware/TSAL Control/QUTMS_Transistors.PcbLib
hardware/TSAL Control/QUTMS_Transistors.SchLib
hardware/TSAL Control/QUTMS_TrimmerLibrary.pcblib
hardware/TSAL Control/QUTMS_TrimmerLibrary.schlib
hardware/TSAL Control/StandardCapacitors.PcbLib
hardware/TSAL Control/StandardCapacitors.SchLib
hardware/TSAL Control/StandardResistors.SchLib
hardware/TSAL Control/StandardTest.SchLib
hardware/TSAL Control/TASLfull.PcbLib
hardware/TSAL Control/TSAL-P01-V00-TSALControl.PcbDoc
hardware/TSAL Control/TSAL-S01-V00-Control.SchDoc
hardware/TSAL LED/CellMonitor.PcbLib
hardware/TSAL LED/CellMonitor.SchLib
hardware/TSAL LED/FFCConnectors.PcbLib
hardware/TSAL LED/FFCConnectors.SchLib
hardware/TSAL LED/IDCConnectors.PcbLib
hardware/TSAL LED/IDCConnectors.SchLib
hardware/TSAL LED/LED STRING.PrjPcb
hardware/TSAL LED/LED-drive-Green.SchDoc
hardware/TSAL LED/LED-drive-Red.SchDoc
hardware/TSAL LED/OLD.PrjPcb
hardware/TSAL LED/QUTMS-TSAL2-S00.SchDoc
hardware/TSAL LED/QUTMS-TSAL2-S01.SchDoc
hardware/TSAL LED/QUTMS-TSAL2-S04.SchDoc
hardware/TSAL LED/QUTMS-TSAL-B00.PcbDoc
hardware/TSAL LED/QUTMS-TSAL-LEDs.SchDoc
hardware/TSAL LED/QUTMS-TSAL-NEW-S01.SchDoc
hardware/TSAL LED/QUTMS-TSAL-NEW-S04.SchDoc
hardware/TSAL LED/QUTMS-TSAL-S00.SchDoc
hardware/TSAL LED/QUTMS-TSAL-S01.SchDoc
hardware/TSAL LED/QUTMS-TSAL-S02.SchDoc
hardware/TSAL LED/QUTMS-TSAL-S03.SchDoc
hardware/TSAL LED/QUTMS-TSAL-S04.SchDoc
hardware/TSAL LED/QUTMS-TSAL.PrjPcb
hardware/TSAL LED/QUTMS_CANLibrary.PcbLib
hardware/TSAL LED/QUTMS_CANLibrary.SchLib
hardware/TSAL LED/QUTMS_CrystalLibrary.PcbLib
hardware/TSAL LED/QUTMS_CrystalLibrary.SchLib
hardware/TSAL LED/QUTMS_DiodeLibrary.PcbLib
hardware/TSAL LED/QUTMS_DiodeLibrary.SchLib
hardware/TSAL LED/QUTMS_InductorLibrary.PcbLib
hardware/TSAL LED/QUTMS_InductorLibrary.SchLib
hardware/TSAL LED/QUTMS_IsolatorLibrary.PcbLib
hardware/TSAL LED/QUTMS_IsolatorLibrary.SchLib
hardware/TSAL LED/QUTMS_JumperLibrary.PcbLib
hardware/TSAL LED/QUTMS_JumperLibrary.SchLib
hardware/TSAL LED/QUTMS_LEDLibrary.PcbLib
hardware/TSAL LED/QUTMS_LEDLibrary.SchLib
hardware/TSAL LED/QUTMS_MicrofitLibrary.PcbLib
hardware/TSAL LED/QUTMS_MicrofitLibrary.SchLib
hardware/TSAL LED/QUTMS_OctocouplerLibrary.PcbLib
hardware/TSAL LED/QUTMS_OctocouplerLibrary.SchLib
hardware/TSAL LED/QUTMS_PCBLibrary.PcbLib
hardware/TSAL LED/QUTMS_PCBLibrary.SchLib
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
