QUT-Motorsport/QUTMS_TSAL/(commit log)

2019-06-14 Board finished, exported gerbers. Freeze Rev1
    [QUTMS_TSAL_V2.PrjPcb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]
2019-06-15 Added cases
    [TSAL COVER.IGS, TSAL COVER.STEP, TSAL SHROUD.IGS]
2020-01-20 update to altium 2020
    [TSAL.PcbDoc]
2020-01-20 remove year being printed on board
    [TSAL.PcbDoc]
2020-01-21 remove year being printed on silkscreen.
    [TSAL.PcbDoc]
2020-01-21 Add dimensions to board
    [TSAL.PcbDoc]
2020-07-10 Added Joseph's QEV3 TSAL Design
    Removed pcb schematics etc from previous work. This design will be used on QEV3 in 2020.
    [CellMonitor.PcbLib, CellMonitor.SchLib, Control.SchDoc, FFCConnectors.PcbLib, FFCConnectors.SchLib, IDCConnectors.PcbLib, IDCConnectors.SchLib, LEDs.SchDoc]
2020-07-12 Add files via upload
    V00.1 Fixed minor routing error
    [QUTMS-TSAL-V00.PrjPcb, QUTMS-TSAL-V01-B00.PcbDoc]
2020-07-13 Add files via upload
    Streamlined rectangular PCB arrangement without M3 mounting holes
    [CellMonitor.PcbLib, CellMonitor.SchLib, FFCConnectors.PcbLib, FFCConnectors.SchLib, IDCConnectors.PcbLib, IDCConnectors.SchLib, QUTMS-TSAL-V01-B00.PcbDoc, QUTMS-TSAL-V01-S00.SchDoc]
2020-07-13 Add files via upload
    Added .step cad model and fixed silkskreen label covering solder pad
    [QUTMS-TSAL-V01-B00.PcbDoc]
2020-07-13 Removed previous version with mounting holes
    [CellMonitor.PcbLib, CellMonitor.SchLib, FFCConnectors.PcbLib, FFCConnectors.SchLib, IDCConnectors.PcbLib, IDCConnectors.SchLib, QUTMS-TSAL-V00-B00.PcbDoc, QUTMS-TSAL-V00-S00.SchDoc]
2020-07-16 Organize into hardware folder
    [CellMonitor.PcbLib, CellMonitor.SchLib, FFCConnectors.PcbLib, FFCConnectors.SchLib, IDCConnectors.PcbLib, IDCConnectors.SchLib, QUTMS-TSAL-V01-B00.PcbDoc, QUTMS-TSAL-V01-S00.SchDoc]
2020-07-16 V2 Ultra-strealined version
    Relocated outermost LEDs to reduce total board width. QUTMS logo has been omitted to save space
    [QUTMS-TSAL-B00.PcbDoc, QUTMS-TSAL-S00.SchDoc, QUTMS-TSAL-S01.SchDoc, QUTMS-TSAL-S02.SchDoc, QUTMS-TSAL-S03.SchDoc, QUTMS-TSAL-S04.SchDoc, QUTMS-TSAL-V01-B00.PcbDoc, QUTMS-TSAL-V01-S00.SchDoc]
2020-07-23 Minor Routing Changes
    Increased the diameter of power via holes to .6mm from .4mm.
    Fixed GND pour polygon shape to remove isolated floating pours
    [QUTMS-TSAL-B00.PcbDoc]
2020-07-28 Minor DRC Edits
    [QUTMS-TSAL-B00.PcbDoc, QUTMS-TSAL-S02.SchDoc, QUTMS-TSAL-S03.SchDoc, QUTMS_LEDLibrary.PcbLib, QUTMS_LEDLibrary.SchLib]
2020-07-28 Ready for Manufacture
    [QUTMS-TSAL-B00.GBL, QUTMS-TSAL-B00.GBO, QUTMS-TSAL-B00.GBS, QUTMS-TSAL-B00.GKO, QUTMS-TSAL-B00.GM1, QUTMS-TSAL-B00.GTL, QUTMS-TSAL-B00.GTO, QUTMS-TSAL-B00.GTS]
2020-07-28 Ready for Manufacture 2: Electric Boogaloo
    Fixed board outline
    [QUTMS-TSAL-B00.GBL, QUTMS-TSAL-B00.GBO, QUTMS-TSAL-B00.GBS, QUTMS-TSAL-B00.GKO, QUTMS-TSAL-B00.GM1, QUTMS-TSAL-B00.GTL, QUTMS-TSAL-B00.GTO, QUTMS-TSAL-B00.GTS]
2020-07-28 TSAL Control (READ DESC.)
    TSAL Control board, moved here from AMU-V00. Current iteration is being sent for manufacture, hence this file should not need to be editted unless there was an error in design.
    Note the Schematic/PCB libraries in this folder (currently TSAL Control) are not, at the time of writing, the same libraries as the ones outside the folder, and should not be mixed until they have been updated together.
    [CellMonitor.PcbLib, CellMonitor.SchLib, FFCConnectors.PcbLib, FFCConnectors.SchLib, IDCConnectors.PcbLib, IDCConnectors.SchLib, OpAmpAttempt.SchLib, QUTMS-TSAL-V00.PrjPcb]
2020-07-28 TSAL Control Correction (Isolation)
    An error was detected in the TSAL Control board before it was sent for manufacture. Added (minimum) 4mm isolation barrier between 90-110V detection system and LED control circuit, the resulting circuit being longer and thinner.
    Additional files relevant to TSAL Control board added, for archive purposes.
    [QUTMS-TSAL-V00.PrjPcb, StandardCapacitors.PcbLib, StandardCapacitors.SchLib, StandardResistors.PcbLib, StandardResistors.SchLib, StandardTest.PcbLib, StandardTest.SchLib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]
2020-07-29 Added BOM
    Created BOM sheet and updated description of component libraries
    [QUTMS-TSAL-B00.PcbDoc, QUTMS-TSAL-S00.SchDoc, QUTMS-TSAL-S01.SchDoc, QUTMS-TSAL-S02.SchDoc, QUTMS-TSAL-S03.SchDoc, QUTMS-TSAL-S04.SchDoc, QUTMS-TSAL.PrjPcb, QUTMS_DiodeLibrary.SchLib]
2020-07-30 BOM excel exported
    [QUTMS-TSAL-CONTROL.xlsx, QUTMS-TSAL-LED.xlsx, QUTMS-TSAL.PrjPcb]
2020-07-30 Cleaned TSAL folders
    Added separate folders for TSAL control and LED boards
    [CellMonitor.PcbLib, CellMonitor.SchLib, FFCConnectors.PcbLib, FFCConnectors.SchLib, IDCConnectors.PcbLib, IDCConnectors.SchLib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]
2020-08-28 TSAL Rev2 Fix
    Swapped mostly useless soft start capacitor (C2) for 10k resistor (R3) to drain residual voltage from CTRL pin to allow LED drivers to turn off when input signal in low.
    [QUTMS-TSAL-B00.GBL, QUTMS-TSAL-B00.GBO, QUTMS-TSAL-B00.GBS, QUTMS-TSAL-B00.GKO, QUTMS-TSAL-B00.GM1, QUTMS-TSAL-B00.GTL, QUTMS-TSAL-B00.GTO, QUTMS-TSAL-B00.GTS]
2020-09-24 TSAL Control Update
    TSAL Control update with fixed P-Channel MOSFETs. Old outdated export files removed
    [QUTMS-TSAL-CONTROL.xlsx, QUTMS-TSAL-V00.PrjPcb, QUTMS_BMS_Interface_V1.PrjPcb, QUTMS_Transistors.SchLib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]
2020-09-24 TSAL Control Rev2
    Revision 2 fixes, 555 timer V+ rerouted and P-channel MOSFETs wired correctly
    [QUTMS-TSAL-V00.PrjPcb, TSAL-P01-V00-TSALControl.PcbDoc, TSAL-S01-V00-Control.SchDoc]
2020-09-24 FabricationFiles Added
    Added Gerber and NC drill hole files, updated DRC report, SmartPDF and 3D file
    [QUTMS-TSAL-V00.PrjPcb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]
2020-09-25 Rev2 ready 2 manufacture
    Correctly set isolation barrier and minor adjustment of silkscreen labels
    [QUTMS-TSAL-V00.PrjPcb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]
2020-10-13 Added BOM output
    [QUTMS-TSAL-V00.xls]
2020-10-13 Fixed BOM output file
    [QUTMS-TSAL-V00.xls, QUTMS-TSAL-V00.xlsx]
2021-06-22 Finished board
    haven't changed all calcs on side
    [QUTMS-TSAL-B00.PcbDoc, QUTMS-TSAL-S00.SchDoc, QUTMS-TSAL-S01.SchDoc, QUTMS-TSAL-S03.SchDoc, QUTMS-TSAL-S04.SchDoc, QUTMS-TSAL-V00.PrjPcb, QUTMS-TSAL.PrjPcb, QUTMS_DiodeLibrary.PcbLib]
2021-07-02 updated with new LED IC
    updated the LED driver IC with a new one hat is available on arrow and updated current sense resistor
    [QUTMS-TSAL-B00.PcbDoc, QUTMS-TSAL-S01.SchDoc, QUTMS_PowerSupplyLibrary.PcbLib, QUTMS_PowerSupplyLibrary.SchLib, StandardResistors.PcbLib]
2021-07-07 building schematic and libraries for easy transfer
    [QUTMS-TSAL-S01.SchDoc, TSALdrive.PcbLib, TSALdrive.SchLib]
2021-07-12 new 3
    [QUTMS-TSAL2-S01.SchDoc, QUTMS-TSAL2-S04.SchDoc]
2021-07-12 LED drive done
    [CellMonitor.PcbLib, CellMonitor.SchLib, FFCConnectors.PcbLib, FFCConnectors.SchLib, IDCConnectors.PcbLib, IDCConnectors.SchLib, LED STRING.PrjPcb, LED-drive-Green.SchDoc]
2021-07-14 routing mostly done for LED board
    [QUTMS-TSAL-LEDs.SchDoc, TSAL-LED_STRING.PcbDoc]
2021-07-15 upd 1
    [QUTMS-TSAL-LEDs.SchDoc]
2021-07-15 routing and gerbers done
    [LED-drive-Green.SchDoc, LED-drive-Red.SchDoc, QUTMS-TSAL-LEDs.SchDoc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]
2021-07-15 BOM and gerb done
    [LED STRING.PrjPcb, LED STRING.xlsx, QUTMS-TSAL2-S00.SchDoc, QUTMS-TSAL2-S01.SchDoc, QUTMS-TSAL2-S04.SchDoc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]
2021-07-15 Heatsink plane and rexport
    [TSAL-LED_STRING.GBL, TSAL-LED_STRING.GBO, TSAL-LED_STRING.GBP, TSAL-LED_STRING.GBS, TSAL-LED_STRING.GKO, TSAL-LED_STRING.GM1, TSAL-LED_STRING.GTL, TSAL-LED_STRING.GTO]
2021-11-10 created bom
    [LED STRING.PrjPcb, LED STRING.xlsx]
